ekorudiawan/AMTEK-Assembly-Machine/Document/Pneumatic Diagram.dxf

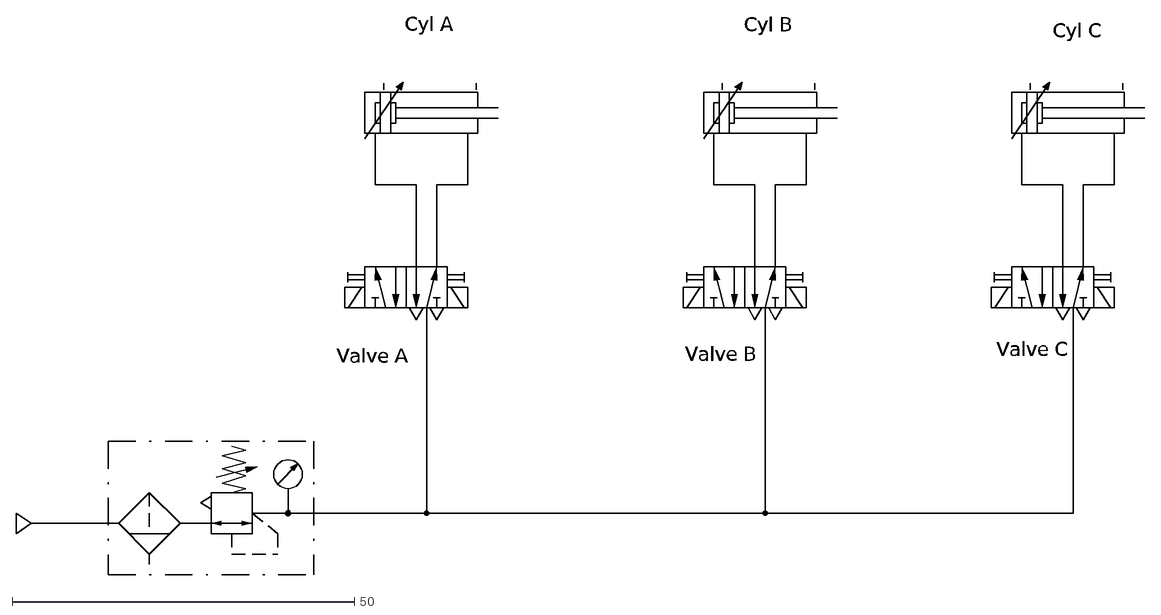
[picture p1: CAD file, 2016-10-16]
Document/Pneumatic Diagram.dxf
Cyl A
Cyl B
Valve A
Valve B
Cyl C
Valve C
