ekorudiawan/AMTEK-Assembly-Machine/(list of files, cad)

Other CAD files:
Document/Input_PLC.dwg
Document/Pneumatic-Diagram1.dwg
Document/Schematic_Diagram.dwg
Document/Output_PLC.dwg
Document/Box_Panel.dwg
Document/Pneumatic_Diagram.dwg
