ekorudiawan/AMTEK-Assembly-Machine/Document/Box_Panel Model.pdf

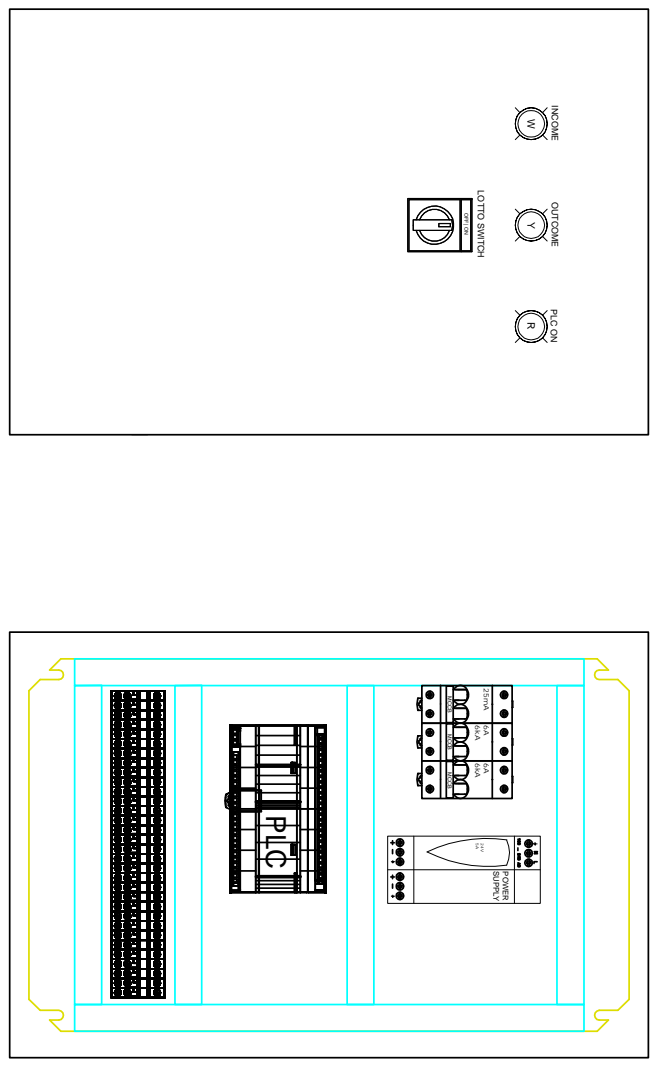
[picture p2: page 1]

Y 25mA 6kA 6A 6kA 6A OFF | ON REV DATE DESCRIPTION DRAWN CHECKED APPROVE SCALE PROJECT NO : DRAWING NO : SHEET : TITLE : PROJECT : BUILDER : OWNER : 5A24V R W PLC INCOME OUTCOME PLC ON LOTTO SWITCH MCCB MCCB MCCB SUPPLY POWER
