ekorudiawan/AMTEK-Assembly-Machine/Document/Pneumatic_Diagram Model.pdf

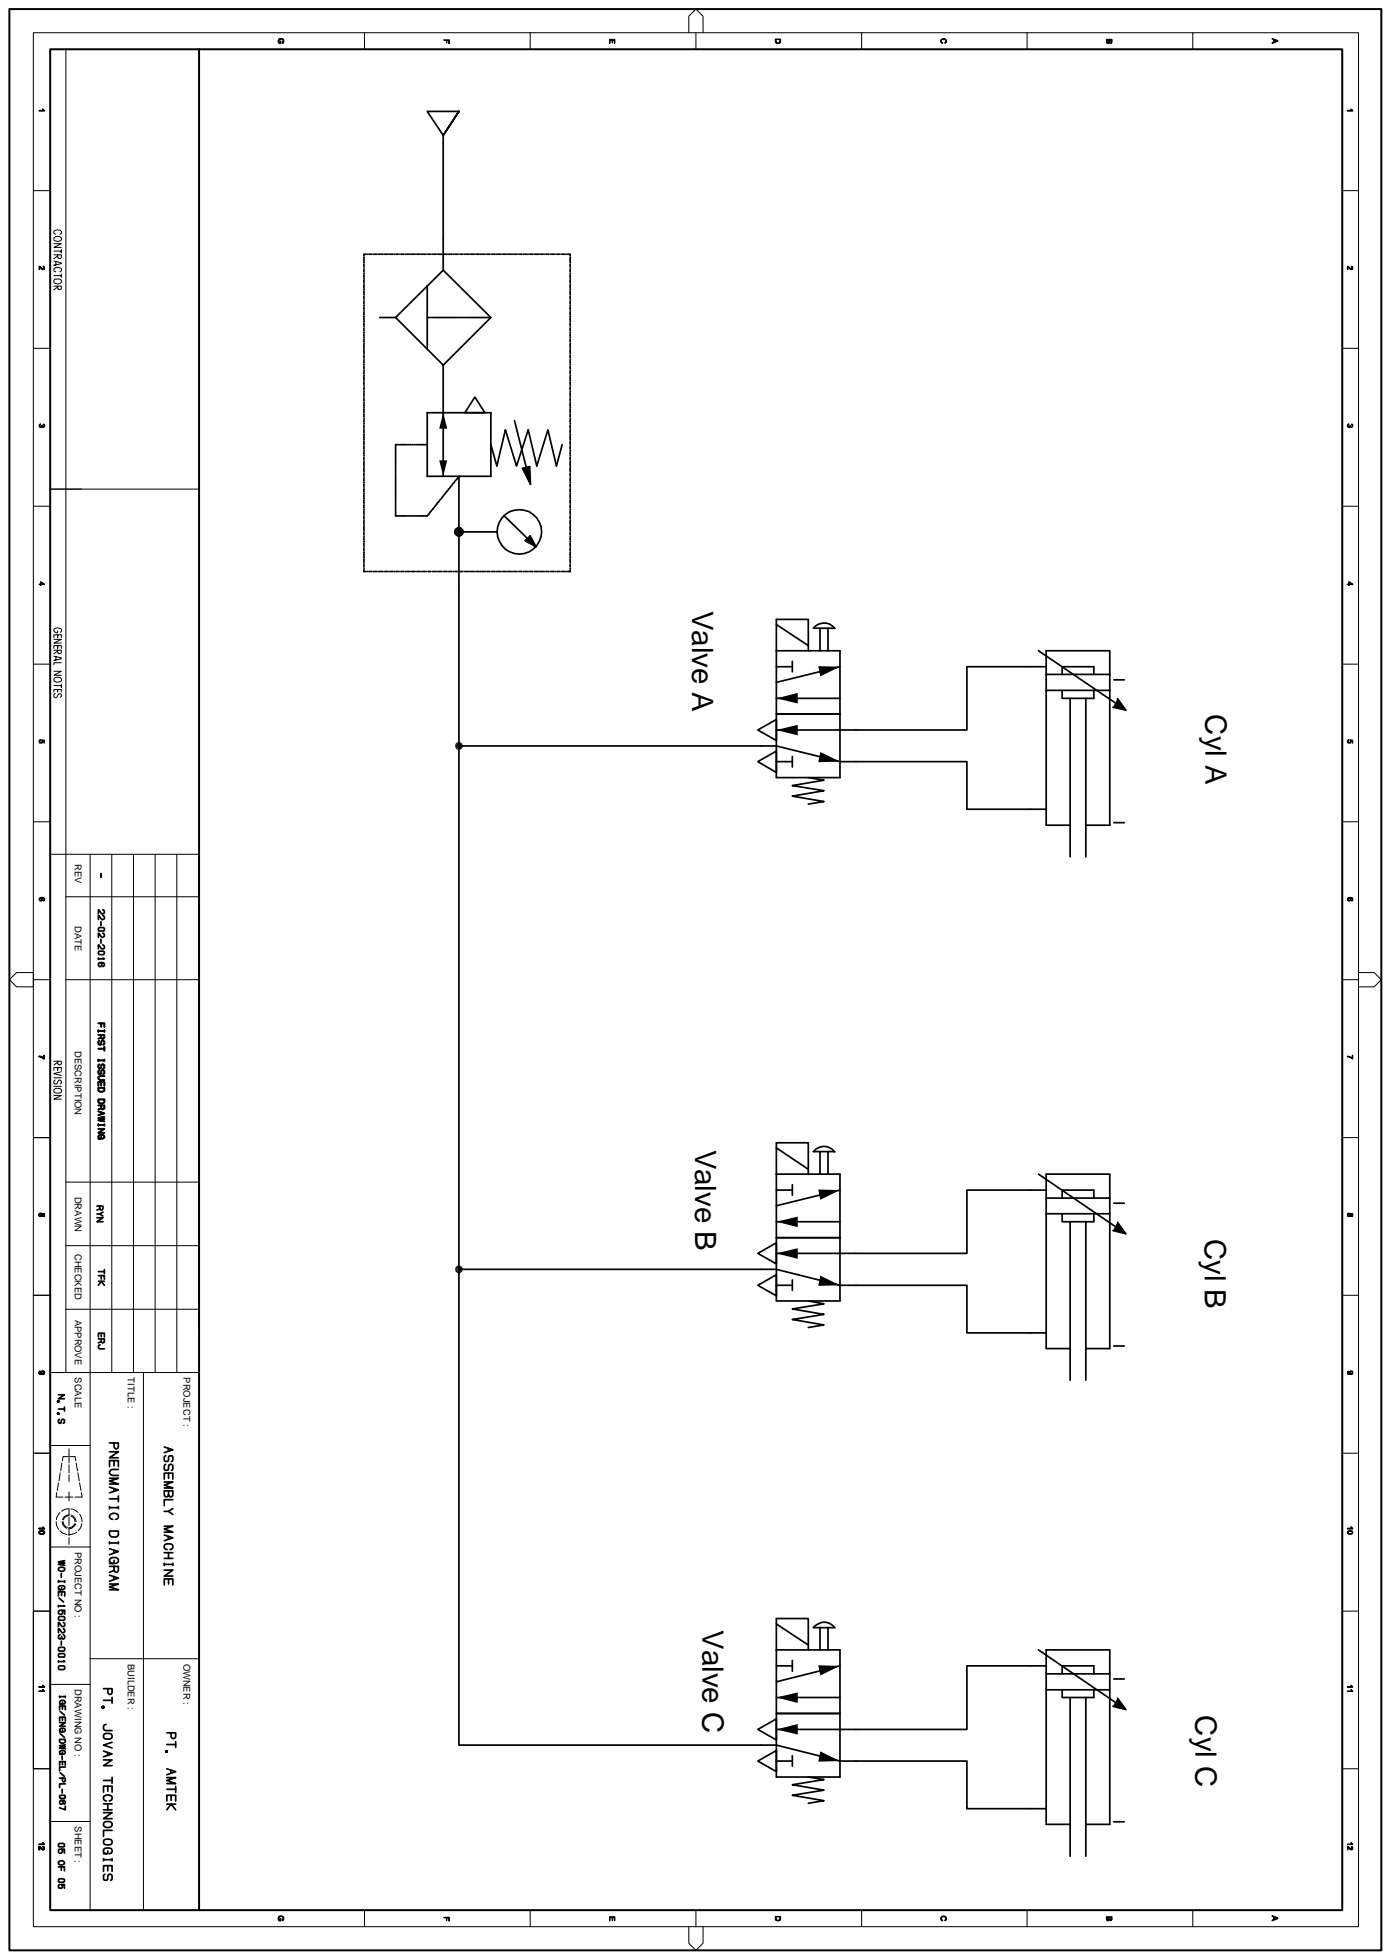
[picture p3: page 1]

REV DATE DESCRIPTION DRAWN CHECKED APPROVE SCALE PROJECT NO : DRAWING NO : SHEET : TITLE : PROJECT : BUILDER : OWNER : Cyl A Cyl B Valve A Valve B Cyl C Valve C
