ekorudiawan/AMTEK-Assembly-Machine/Document/Schematic_Diagram ModeL.pdf

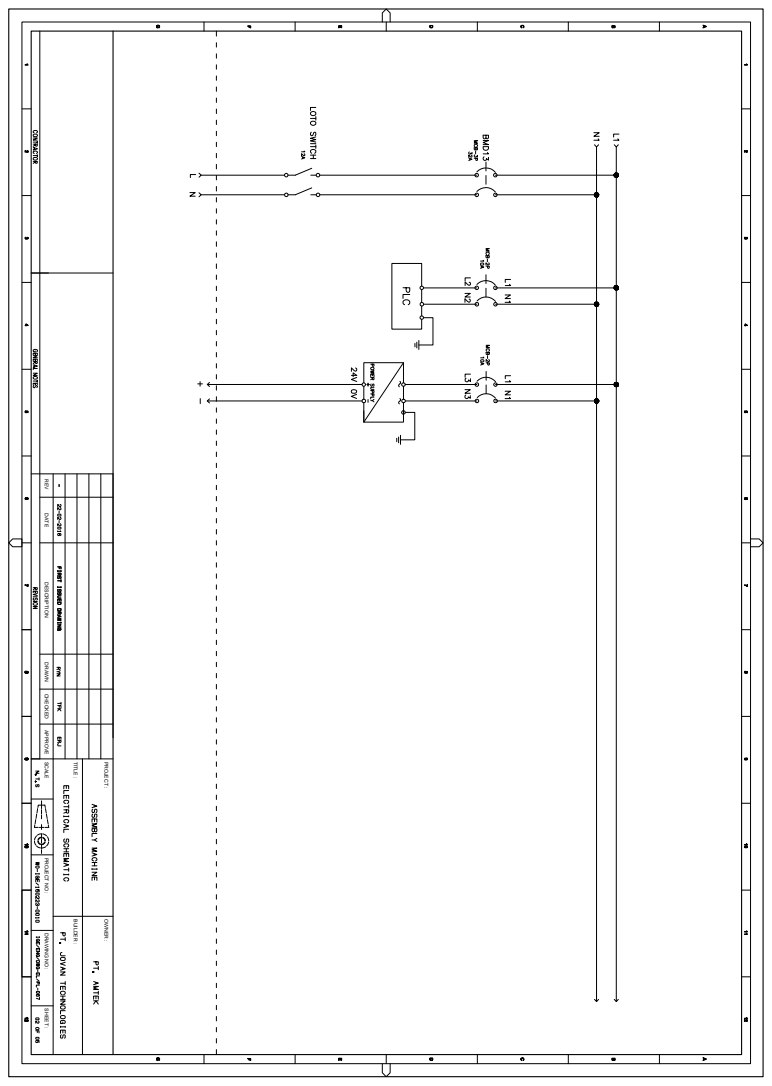
[picture p4: page 1]

REV DATE DESCRIPTION DRAWN CHECKED APPROVE SCALE PROJECT NO : DRAWING NO : SHEET : TITLE : PROJECT : BUILDER : OWNER :
