ekorudiawan/AMTEK-Assembly-Machine/Document/Input_PLC Model.pdf

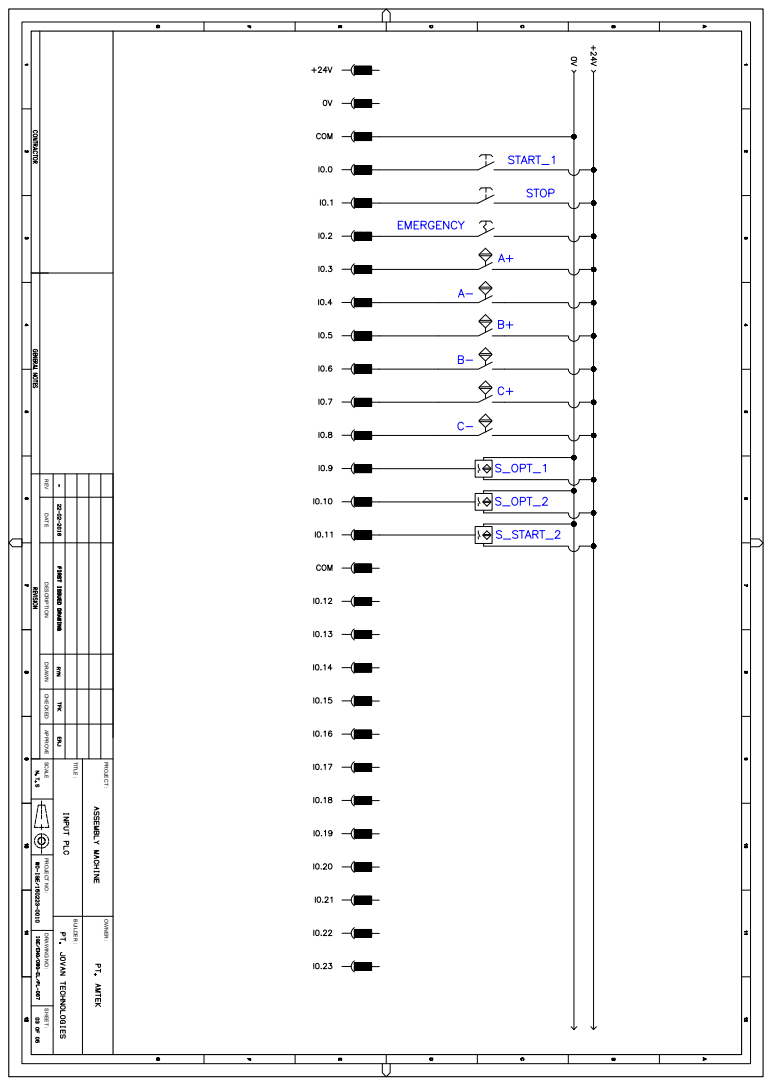
[picture p5: page 1]

REV DATE DESCRIPTION DRAWN CHECKED APPROVE SCALE PROJECT NO : DRAWING NO : SHEET : TITLE : PROJECT : BUILDER : OWNER :
