ekorudiawan/AMTEK-Assembly-Machine/Document/Output_PLC Model.pdf

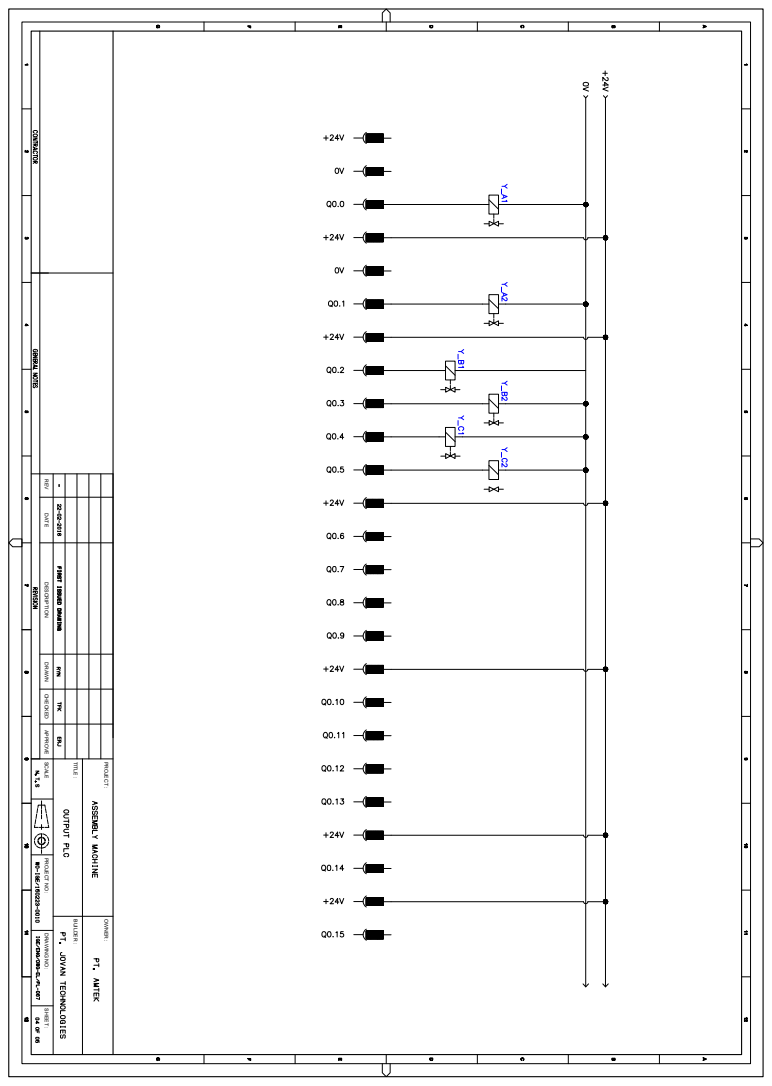
[picture p6: page 1]

REV DATE DESCRIPTION DRAWN CHECKED APPROVE SCALE PROJECT NO : DRAWING NO : SHEET : TITLE : PROJECT : BUILDER : OWNER :
